v0l/rotator/BOM-aliexpress.md

# Bill of materials, AliExpress version

Searched on AliExpress Ireland on 16 Oct 2026. Prices are in EUR with Irish VAT included,
and each is the listing's lowest option, so the size or quantity you need may cost
more. Delivery is usually free over €10 per seller. Made parts are in `QUOTE.md`.

## Bought on AliExpress

| qty | part | listing | from |
|---|---|---|---|
| 1 | KFL003 flange bearing, 17 mm, pair (az) | [1005007213247542](https://www.aliexpress.com/item/1005007213247542.html) | €7.60 |
| 1 | KFL001 flange bearing, 12 mm option, pair (el) | [1005007098430647](https://www.aliexpress.com/item/1005007098430647.html) | €4.23 |
| 1 | 608-2RS, pack of 10 (4 used) | [1005009361976252](https://www.aliexpress.com/item/1005009361976252.html) | €6.51 |
| 1 | Cable gland M16, IP68, pack of 10 (2 used, az box) | [1005003093251442](https://www.aliexpress.com/item/1005003093251442.html) | €3.62 |
| 1 | Breather vent M12x1.5, IP68 (az box) | [1005012041466313](https://www.aliexpress.com/item/1005012041466313.html) | €3.25 |
| 1 | V-ring VA12, NBR (el lid) | [1005009431336215](https://www.aliexpress.com/item/1005009431336215.html) | €3.46 |
| 1 | Shaft collar 12 mm, set screw (el lid side) | [1005012631701483](https://www.aliexpress.com/item/1005012631701483.html) | €2.96 |
| 2 | Silver steel bar 330 mm, one 8 mm (worm shafts) and one 12 mm (el shaft) | [4000817450571](https://www.aliexpress.com/item/4000817450571.html) | €2.07 each |
| 1 | Feather key 4x4, 304, round ends (el wheel, both arm hubs) | [1005012646738365](https://www.aliexpress.com/item/1005012646738365.html) | €2.80 |
| 1 | Dowel pin Ø4, 304, 30 and 28 long (wheel and collar on the spindle) | [4000473863693](https://www.aliexpress.com/item/4000473863693.html) | €3.05 |
| 1 | Self-clinching nut CLS-M4, 304 (8 used, arm hubs) | [1005012896532691](https://www.aliexpress.com/item/1005012896532691.html) | €3.15 |
| 1 | Hex standoff M3 x 10, aluminium, female-female (4 used, control board) | [1005012423389287](https://www.aliexpress.com/item/1005012423389287.html) | €2.69 |
| 1 | Hex standoff M2.5 x 11, male-female (4 used, optional Pi) | [1005002523300769](https://www.aliexpress.com/item/1005002523300769.html) | €4.43 |
| 2 | Heat-set inserts, brass, 100 pcs, one M3 (gear covers) and one M2.5 (Pi bracket) | [1005006798286851](https://www.aliexpress.com/item/1005006798286851.html) | €4.08 each |
| 1 | Starlock push-on washers, stainless, kit with 4 mm (24 used, parasitic elements) | [1005013043623641](https://www.aliexpress.com/item/1005013043623641.html) | €14.52 |
| 3 | U-bolt, 304, with nuts: M8 for 48 mm (2, mast), M6 for 25 mm (4), M6 for 20 mm (2) | [1005012068399328](https://www.aliexpress.com/item/1005012068399328.html) | €4.64 each |
| 1 | CR123A battery holder with leads | [1005010768477039](https://www.aliexpress.com/item/1005010768477039.html) | €0.52 |
| 5 | Aluminium rod 4 mm, 6061, 1 m (yagi elements, three per bar) | [1005010503222152](https://www.aliexpress.com/item/1005010503222152.html) | €1.63 each |
| 2 | A4 countersunk socket screws DIN 7991: M3x8 (2), M3x12 (24, drive plates) | [1005011829285007](https://www.aliexpress.com/item/1005011829285007.html) | €2.10 each |
| 6 | A4 socket cap screws DIN 912: M3x6, M3x10, M3x14, M4x10, M5x12, M6x16, one pack per size | [1005012860629584](https://www.aliexpress.com/item/1005012860629584.html) | €2.69 each |
| 1 | EPDM sheet 1 mm (gasket under the outside el bearing unit) | [1005011772353226](https://www.aliexpress.com/item/1005011772353226.html) | €3.68 |
| 1 | PETG filament 1 kg, about 150 g used (gear covers, accessory bracket) | [1005008941340930](https://www.aliexpress.com/item/1005008941340930.html) | €12.99 |

AliExpress subtotal from the listed prices: about **€134**.

## Bought elsewhere

| qty | part | where | with VAT |
|---|---|---|---|
| 1 | Hammond 1550WH die-cast box, 222 x 146 x 105, IP66 (az) | [Farnell 1823070](https://ie.farnell.com/search?st=1823070) | €43.16 |
| 1 | Hammond 1550Z117 die-cast box, 160 x 100 x 81, IP66 (el) | [Farnell 2763846](https://ie.farnell.com/search?st=2763846) | €36.08 |
| 1 | KHK CG1-60R1 wheel and SW1-R1 worm, m1, 60:1 (az, £46.28) | [R.A. Rodriguez](https://www.rargears.com/gears/worm-wheels/gray-iron-worm-wheels/cg1-60r1) | €67.20 |
| 1 | KHK BG0.8-60R1 bronze wheel and SW0.8-R1 worm, m0.8, 60:1 (el) | R.A. Rodriguez | not priced |
| 2 | StepperOnline 17HS15-1504-ME1K closed-loop NEMA17 (£14.36 each) | [17HS15-1504-ME1K](https://www.omc-stepperonline.com/nema-17-closed-loop-stepper-motor-45ncm-64oz-in-with-magnetic-encoder-1000ppr-4000cpr-17hs15-1504-me1k) | €41.70 |
| 1 | Molex 73100-0037 N jack bulkhead, crimp, RG-58 (el box floor; $13.10 ex VAT) | [Mouser 538-73100-0037](https://www.mouser.com/ProductDetail/Molex/73100-0037?qs=UWfdUHhsSi4LdzZbo9j%252B7A%3D%3D) | not totalled |
| 1 | Aluminium tube 25 x 2, 1 m (yagi bracket, 390 used) | [Goodwins](https://www.goodwins.ie/products/id-30577.html) | €10.95 |
| 1 | Aluminium tube 20 x 1.5, 1 m (yagi boom, 932 used) | [Aluminium Online](https://www.aluminium-online.co.uk) | not priced |
| 1 | 42CrMo4+QT (4140 pre-hard) bar Ø20 x 120 (az spindle) | steel stockholders | not priced |
| 2 | M8 V-saddle for 48 mm tube, A4 (mast clamp) | aerial suppliers | not priced |
| 2 | Dipole centre insulator box for a 20 mm boom (split driven elements) | DK7ZB, WiMo | not priced |
| | O-ring sealing screws: M3x8 (4), M4x10 (4), M4x16 (4), M4x22 (4), M6x16 (2), M6x25 (2); M4 spacers Ø8 x 7.5, A4 (4); nuts M3 (2), M4 (4), M6 nyloc (4), M8 nyloc (4) with sealing washers; washers 5.3 x 20 (2) | [Accu](https://www.accu.co.uk) | not priced |
| 1 | Control board parts (`board/tools/bom.md`) | Mouser | €81.14 |
| 1 | CR123A lithium cell, RJ45 plug for the PoE cable | any | |
| | Optional Pi and SDR: Raspberry Pi 5, PoE HAT, RTL-SDR Blog V4, short USB-A extension | Raspberry Pi resellers, rtl-sdr.com | |

The KHK worm pairs stay because the drive plates hold each worm at the KHK centre
distance (38 mm az, 31 mm el) and the gear covers are drawn around their sizes. The two
boxes stay with Farnell because the whole model and its drilling are drawn around these
Hammond parts.

## Total

About **€414 with VAT** for the priced rows: €134 on AliExpress and €280 elsewhere. The
el worm pair, the N-type bulkhead, the boom tube, the spindle bar, the saddles, the
insulators and the Accu hardware are not in it. Made parts are the same as in `BOM.md`
and still need quotes.

## Before ordering

- The AliExpress KFL units are generic zinc castings. Check the bolt spacing and centre
  height against `parts/std/kfl002.gcad` as used in the assemblies (KFL003 a=71 e=56,
  KFL001 a=63 e=48), since the boxes are drilled to them.
- Pick the 2RS option on the 608 listing and the 12 mm bore on the KFL001 listing.
- The silver steel bar is not ground to a stated tolerance; check it fits the KFL001
  bore, the el wheel bore and the 608 inner rings before cutting the keyways and D-bore.
- Pick the U-bolt sizes for 48, 25 and 20 mm tube on the U-bolt listing.
- Check the aluminium rod listing offers a 1 m length; the longest element is 346 mm.
