v0l/rotator/BOM.md

# Bill of materials (bought parts)

Prices checked on 9 Oct 2026 (Hammond boxes on 16 Oct), unit prices ex VAT. Made parts (plates, yoke, shafts,
collar) and drilling the boxes are in `QUOTE.md`.

## Farnell Ireland (EUR, free delivery over €75)

| qty | part | order code | unit | total |
|---|---|---|---|---|
| 2 | TE 1478769-2 cable gland M16, IP68, with locknut | [1174602](https://ie.farnell.com/te-connectivity/1478769-2/cable-gland-pa-10mm-m16-black/dp/1174602) | €4.07 | €8.14 |
| 1 | TE 2490541-2 breather vent M12x1.5 | [4753219](https://ie.farnell.com/amp-te-connectivity/2490541-2/ventilation-cable-gland-70l-h/dp/4753219) | €4.40 | €4.40 |
| 1 | Hammond 1550WH die-cast box, 222 x 146 x 105, IP66 (az) | [1823070](https://ie.farnell.com/search?st=1823070) | €35.09 | €35.09 |
| 1 | Hammond 1550Z117 die-cast box, 160 x 100 x 81, IP66 (el) | [2763846](https://ie.farnell.com/search?st=2763846) | €29.33 | €29.33 |
| | | | | **€76.96** |

## Simply Bearings Ireland (EUR)

| qty | part | link | unit | total |
|---|---|---|---|---|
| 2 | KFL003 flange bearing unit, 17 mm (az) | [kfl003](https://www.simplybearings.ie/products/kfl003) | €9.82 | €19.64 |
| 4 | SKF 608-2RSH | [608-2rsh-skf](https://www.simplybearings.ie/products/608-2rsh-skf) | €6.12 | €24.48 |
| 1 | Silver steel 8 mm x 325, cut into two 83 mm worm shafts | [ssm0080-325mm](https://www.simplybearings.ie/products/ssm0080-325mm) | €9.26 | €9.26 |
| | | | | **€53.38** |

## R.A. Rodriguez, KHK distributor (UK, GBP)

| qty | part | link | unit | total |
|---|---|---|---|---|
| 1 | KHK CG1-60R1 worm wheel, m1, 60:1, cast iron (az) | [cg1-60r1](https://www.rargears.com/gears/worm-wheels/gray-iron-worm-wheels/cg1-60r1) | £26.86 | £26.86 |
| 1 | KHK SW1-R1 steel worm, m1 (az) | [SW1-R1](https://www.rargears.com/gears/worm-wheels/steel-worms/SW1-R1) | £19.42 | £19.42 |
| | | | | **£46.28** |

The el pair, KHK BG0.8-60R1 (bronze, m0.8, 60:1) and SW0.8-R1, is not price-checked.

The wheels come with plain bores and the worms with 6 mm; the reboring is in `QUOTE.md`. RAR does not list the bronze BG1-60R1. Its
bronze 60:1 option is AG1-60R1J15 (£158.85, already bored 15 mm with keyway), but that
pairs with the SWG1-R1 ground worm (£80.12), which I have not modelled. Shipping from
the UK adds Irish import VAT and a carrier handling fee.

## StepperOnline (GBP, EU warehouse)

| qty | part | link | unit | total |
|---|---|---|---|---|
| 2 | 17HS15-1504-ME1K closed-loop NEMA17, 45 Ncm, magnetic encoder 1000 PPR built in, 43.5 mm long | [17HS15-1504-ME1K](https://www.omc-stepperonline.com/nema-17-closed-loop-stepper-motor-45ncm-64oz-in-with-magnetic-encoder-1000ppr-4000cpr-17hs15-1504-me1k) | £14.36 | £28.72 |
| | | | | **£28.72** |

## Not price-checked yet

| qty | part | where |
|---|---|---|
| 2 | KFL001 flange bearing unit, 12 mm (el) | [Simply Bearings](https://www.simplybearings.co.uk/products/kfl001) |
| 1 | V-ring VA12 nitrile, for 11.5-13.5 mm shafts (el lid) | Simply Bearings |
| 1 | Shaft collar 12 mm, set screw (el lid side) | Simply Bearings |
| 1 | Silver steel 12 mm x 325 (el shaft) | Simply Bearings |
| 1 | 42CrMo4+QT (4140 pre-hard) bar Ø20 x 120 (az spindle) | steel stockholders |
| 2 | Dowel pin Ø4 m6, 30 and 28 long (wheel and collar on the spindle) | Accu |
| 4 | M4 spacer Ø8 x 7.5, A4 (az drive hangers) | Accu |
| 3 | Feather key 4x4, A4 (el wheel, both arm hubs) | Simply Bearings |
| 8 | Self-clinching nut M4 for 3 mm aluminium, PEM CLS-M4-2 or equal (arm hubs) | PennEngineering distributors |
| 2 | M8 U-bolt and V-saddle for 48 mm tube, A4 (mast clamp) | aerial suppliers, Accu |
| 1 | Aluminium tube 25 x 2, 390 mm (yagi bracket) | Goodwins (below) |
| 1 | EPDM sheet 1 mm, for the gasket under the outside el bearing unit | Amazon, Delta Rubber |
| 4 | Hex standoff M3 x 10, female-female, 5.5 mm, aluminium (control board) | [Accu](https://www.accu.co.uk) |
| 1 | Takachi CR123A-R battery holder with 140 mm leads, plus a JST PHR-2 housing and 2 SPH crimps | Conrad, item 1882324 |
| 1 | CR123A lithium cell | any |
| 1 | Molex 73100-0037 N jack bulkhead, crimp, RG-58 (SDR coax out of the el box floor) | [Mouser 538-73100-0037](https://www.mouser.com/ProductDetail/Molex/73100-0037?qs=UWfdUHhsSi4LdzZbo9j%252B7A%3D%3D), $13.10 |
| | Optional Pi and SDR: Raspberry Pi 5, PoE HAT, RTL-SDR Blog V4, 4x M2.5 x 11 male-female standoffs, 4x M2.5 heat-set inserts, 4x M4x10 (bracket to the drive base plate), short USB-A extension | Raspberry Pi resellers, rtl-sdr.com |
| 1 | RJ45 plug for the PoE cable, crimped inside the box after the cable is through the gland | any |
| 1 | Aluminium tube 20 x 1.5, 1 m (yagi boom) | [Aluminium Online](https://www.aluminium-online.co.uk) |
| 5 | Aluminium rod 4 mm, 1 m (yagi elements, three per bar) | [Aluminium Online](https://www.aluminium-online.co.uk) |
| 24 | Push-on star lock washer, 4 mm shaft, A2 (parasitic elements, both sides of the boom) | [Accu](https://www.accu.co.uk) |
| 2 | Dipole centre insulator box for a 20 mm boom (split driven elements) | DK7ZB, WiMo |
| 4 | M6 U-bolt for 25 mm tube, A4, with nuts (two on the cross clamp, two on the yoke) | [Accu](https://www.accu.co.uk) |
| 2 | M6 U-bolt for 20 mm tube, A4, with nuts | [Accu](https://www.accu.co.uk) |
| 12 | Ruthex M3 heat-set insert, 5.7 long (gear covers) | [3DJake Ireland](https://www.3djake.ie/) |
| 1 | PETG filament, about 150 g (gear covers) | [3DJake Ireland](https://www.3djake.ie/) |
| | A4 screws: M3x6 (4), M3x8 countersunk (2), M3x10 (16), M3x12 countersunk (24, drive plates), M3x14 (4), M4x10 (8, arm hubs), M5x12 (2, el shaft ends), M6x16 (4); O-ring sealing screws: M3x8 (4, board), M4x10 (4, el drive base plate), M4x16 (4, az drive hangers), M4x22 (4, collar), M6x16 (2, el KFLs through the walls), M6x25 (2, az KFL003 pair); nuts M3 (2), M4 (4), M6 (4, nyloc), M8 nyloc (4) with sealing washers (mast U-bolts inside the az box); washers 5.3 x 20 (2) | [Accu](https://www.accu.co.uk) |

## Totals in EUR with 23% VAT

GBP converted at 1.1805 (mid-market, 9 Oct 2026). Shipping not included.

| supplier | ex VAT | with VAT |
|---|---|---|
| Farnell Ireland | €76.96 | €94.66 |
| Simply Bearings Ireland | €53.38 | €65.66 |
| R.A. Rodriguez (£46.28) | €54.63 | €67.20 |
| StepperOnline (£28.72) | €33.90 | €41.70 |
| Goodwins, 25 mm tube x 1 m | €8.90 | €10.95 |
| Control board parts, Mouser (`board/tools/bom.md`) | €65.97 | €81.14 |
| **priced parts** | **€293.74** | **€361.31** |

The unpriced rows include the el worm pair and the KFL001s, so the
priced total is well short of the bought parts; they need pricing before the total means
anything. The control board PCB (4 layers, ENIG, JLCPCB) and its assembly are not priced yet,
and its STM32H563RIT6 is on backorder (Mouser expects stock on 11 Dec 2026). The made parts in
`QUOTE.md` still need quotes.

## Other Irish suppliers

Found by search, stock and prices not checked unless noted.

| need | supplier |
|---|---|
| Bearings, KFL units, taper-lock bushes and hubs, couplings | [Central Bearing Supplies](https://www.cbsbearings.com/), [Dickson Bearings](https://dicksonbearings.ie/), [Bearings Online](https://www.bearingsonline.ie/), [MecTec](http://www.mectec.ie/store/bearings) |
| Worm wheels | [RS Ireland](https://ie.rs-online.com/web/c/mechanical-power-transmission/gears-racks/worm-pinion-gears/) (RS PRO bronze wheels), [C.H.L. Engineering](http://www.chlengineering.ie/product-types/gears) (cut to order) |
| A4 stainless screws, nuts, washers | [Inox.ie](https://www.inox.ie/acatalog/Cap_Screws.html), [Bolts and Nuts](https://www.boltsandnuts.ie/), [Würth Ireland](https://eshop.wurth.ie/) (trade accounts) |
| NEMA17 motors, maker parts | [Gleanntronics](https://gleanntronics.ie/), [3DJake Ireland](https://www.3djake.ie/), [Mouser Ireland](https://www.mouser.ie/) |
| 25 mm aluminium tube | [Goodwins](https://www.goodwins.ie/products/id-30577.html) (25 mm x 1 m, €8.90 ex VAT, 15 in stock), [Lenehans](https://www.lenehans.ie/round-profile-anodised-aluminium-25mm-x-1m.html), [Impact Aluminium](https://www.impactaluminium.ie/product-category/profile/tube/) |
| Cable glands | [Electrical Wholesaler Ireland](https://www.electricalwholesaler.ie/en/products/m16-cable-gland-locknut-grey-5-10mm-cable-entry-ip68-q-crimp) (M16 IP68, pack of 10) |
| Laser-cut plates | [ATC Group](https://atcgroup.ie/laser-cutting-quote/), [Laserprofiling.ie](https://laserprofiling.ie/), [lasercutting.ie](http://www.lasercutting.ie/), [CS Fabrication](https://www.csfabrication.ie/laser-cutting/) |
| Turned and milled parts | [ProNum CNC](https://pronum.ie/), [Profab Services](https://www.profabservices.ie/services/precision-engineering), [cnc.ie quote form](https://www.cnc.ie/get-a-quote.html) (routes to several Irish shops) |
