v0l/rotator/board/tools/bom.md

| Refs | Qty | Value | MPN | Maker | Source | Stock | EUR each (1 board) | EUR each (5 boards) |
|---|---|---|---|---|---|---|---|---|
| C1 | 1 | 10n/100V | GRM21BR72A103KA01L | Murata | Mouser 81-GRM21BR72A103K | 76699 | 0.163 | 0.163 |
| C2 | 1 | 330u/35V | EEH-ZK1V331P | Panasonic | Mouser 667-EEH-ZK1V331P | 10876 | 1.430 | 1.430 |
| C3 | 1 | 10u/50V | C3216X5R1H106K160AB | TDK | Mouser 810-C3216X5R1H106K | 85290 | 1.590 | 1.590 |
| C4 | 1 | 100n/50V | GRM155R71H104KE14D | Murata | Mouser 81-GRM155R71H104KE4D | 16438135 | 0.086 | 0.086 |
| C5 C6 C93 | 3 | 22u/10V | CL21A226MPCLRNC | Samsung | Mouser 187-CL21A226MPCLRNC | 10385 | 0.387 | 0.222 |
| C7 | 1 | 100p/50V | GRM1555C1H101JA01D | Murata | Mouser 81-GRM1555C1H101JA1D | 262856 | 0.095 | 0.095 |
| C20 C23 C24 C25 C26 C28 C30 C63 C64 C66 C75 C82 C98 | 13 | 100n/10V | GRM155R71A104KA01D | Murata | Mouser 81-GRM155R71A104KA1D | 12004 | 0.022 | 0.015 |
| C21 C22 | 2 | 6.8p/50V | GRM1555C1H6R8CA01D | Murata | Mouser 81-GRM1555C1H6R8CA1D | 151365 | 0.103 | 0.024 |
| C27 | 1 | 4.7u/10V | C1005X5R1A475K050BC | TDK | Mouser 810-C1005X5R1A475KBC | 1184417 | 0.241 | 0.241 |
| C29 C62 C65 C67 C89 C92 C99 | 7 | 1u/10V | GRM155R61E105MA12D | Murata | Mouser 81-GRM155R61E105MA2D | 319113 | 0.086 | 0.031 |
| C31 C32 | 2 | 2.2u/10V | GRM155R61A225ME01D | Murata | Mouser 81-GRM155R61A225M01D | 2140 | 0.086 | 0.022 |
| C59 C69 C72 C79 | 4 | 22n/50V | GRM155R71H223KA12D | Murata | Mouser 81-GRM155R71H223KA12 | 148519 | 0.095 | 0.021 |
| C60 C61 | 2 | 15p/50V | GRM1555C1H150JA01D | Murata | Mouser 81-GRM1555C1H150JA1D | 156394 | 0.086 | 0.020 |
| C68 | 1 | 470p/50V | GRM1555C1H471JA01D | Murata | Mouser 81-GRM1555C1H471JA01 | 434754 | 0.086 | 0.086 |
| C70 C71 C73 C77 C78 C80 | 6 | 100n/50V | GCM188R71H104KA57D | Murata | Mouser 81-GCM188R71H104KA7D | 400000 | 0.032 | 0.032 |
| C74 C81 | 2 | 4.7u/10V | C0603C475K8PAC | KEMET | Mouser 80-C0603C475K8PAC | 84000 | 0.047 | 0.047 |
| C76 C83 | 2 | 100u/35V | EHBSA035M1010608T | Eaton | Mouser 504-EHBSA035M1010608 | 4633 | 0.955 | 0.608 |
| C90 C91 | 2 | 10u/10V | GRM188R61A106ME69D | Murata | Mouser 81-GRM188R61A106ME9D | 14985 | 0.103 | 0.058 |
| D1 D2 | 2 | MDB10S | MDB10S | onsemi | Mouser 512-MDB10S | 30184 | 0.654 | 0.297 |
| D4 D5 D10 | 3 | B5819W | 1N5819HW-7-F | Diodes | Mouser 621-1N5819HW-F | 424904 | 0.267 | 0.117 |
| FB1 | 1 | 600R | BLM18KG601SN1D | Murata | Mouser 81-BLM18KG601SN1D | 1118109 | 0.086 | 0.086 |
| J1 | 1 | V8BR-1AX1-GH | V8BR-1AX1-GH | Bel | Farnell 3588276 |  | 9.310 | 9.310 |
| J4 J5 | 2 | AZ_ENCODER | B5B-XH-A(LF)(SN) | JST | Mouser 306-B5BXHALFSN | 41491 | 0.172 | 0.149 |
| J7 | 1 | USB4960 | USB4960-00-C | GCT | Mouser 640-USB4960-00-C | 8823 | 0.619 | 0.619 |
| J8 J9 | 2 | AZ_MOTOR | B4B-XH-A(LF)(SN) | JST | Mouser 306-B4BXHALFSN | 63101 | 0.146 | 0.124 |
| J10 | 1 | BATTERY | B2B-PH-K-S(LF)(SN) | JST | Mouser 306-B2BPHKSLFSNPP | 13876 | 0.103 | 0.103 |
| L1 | 1 | 6.8u | SRN4018-6R8M | Bourns | Mouser 652-SRN4018-6R8M | 2701 | 0.344 | 0.344 |
| L3 | 1 | 2.2u | DFE201610E-2R2M=P2 | Murata | Mouser 81-DFE201610E-2R2MP2 | 39805 | 0.215 | 0.215 |
| LED1 | 1 | green | LTST-C191KGKT |  | Mouser 859-LTST-C191KGKT | 1781213 | 0.129 | 0.129 |
| LED2 | 1 | red | LTST-C191KRKT |  | Mouser 859-LTST-C191KRKT | 1323353 | 0.129 | 0.129 |
| R1 | 1 | 24k | ERJ-8ENF2402V | Panasonic | Mouser 667-ERJ-8ENF2402V | 18348 | 0.155 | 0.155 |
| R2 | 1 | 47k | RC0402FR-0747KL | Yageo | Mouser 603-RC0402FR-0747KL | 2308419 | 0.086 | 0.086 |
| R3 | 1 | 205k | RC0402FR-07205KL | Yageo | Mouser 603-RC0402FR-07205KL | 1034710 | 0.086 | 0.086 |
| R4 | 1 | 62k | RC0402FR-0762KL | Yageo | Mouser 603-RC0402FR-0762KL | 271380 | 0.086 | 0.086 |
| R5 | 1 | 499 | RC0402FR-07499RL | Yageo | Mouser 603-RC0402FR-07499RL | 635026 | 0.086 | 0.086 |
| R22 R29 R36 R42 | 4 | 10k | RC0402FR-0710KL | Yageo | Mouser 603-RC0402FR-0710KL | 16045441 | 0.086 | 0.009 |
| R23 R24 | 2 | 5.1k | RC0402FR-075K1L | Yageo | Mouser 603-RC0402FR-075K1L | 1987011 | 0.086 | 0.009 |
| R27 R46 | 2 | 1k | RC0402FR-071KL | Yageo | Mouser 603-RC0402FR-071KL | 3519849 | 0.086 | 0.009 |
| R28 | 1 | 2.2k | RC0402FR-072K2L | Yageo | Mouser 603-RC0402FR-072K2L | 1787135 | 0.095 | 0.095 |
| R30 | 1 | 12.1k | RC0402FR-0712K1L | Yageo | Mouser 603-RC0402FR-0712K1L | 449359 | 0.086 | 0.086 |
| R31 R32 R33 R34 | 4 | 49.9 | RC0402FR-0749R9L | Yageo | Mouser 603-RC0402FR-0749R9L | 2119239 | 0.086 | 0.009 |
| R35 | 1 | 33 | RC0402FR-0733RL | Yageo | Mouser 603-RC0402FR-0733RL | 1235798 | 0.086 | 0.086 |
| R37 | 1 | 1.5k | RC0402FR-071K5L | Yageo | Mouser 603-RC0402FR-071K5L | 1167927 | 0.086 | 0.086 |
| R40 R41 R43 R44 | 4 | 0.11 | RL1632R-R110-F | Susumu | Mouser 754-RL1632R-R110-F | 16159 | 0.232 | 0.193 |
| R50 R57 | 2 | 1M | RC0402FR-071ML | Yageo | Mouser 603-RC0402FR-071ML | 1730803 | 0.086 | 0.009 |
| R52 | 1 | 180k | RC0402FR-07180KL | Yageo | Mouser 603-RC0402FR-07180KL | 251440 | 0.086 | 0.086 |
| R53 R54 | 2 | 100k | RC0402FR-07100KL | Yageo | Mouser 603-RC0402FR-07100KL | 5631536 | 0.086 | 0.009 |
| R58 | 1 | 487k | RC0402FR-07487KL | Yageo | Mouser 603-RC0402FR-07487KL | 605870 | 0.086 | 0.086 |
| R59 | 1 | 200k | RC0402FR-07200KL | Yageo | Mouser 603-RC0402FR-07200KL | 1029898 | 0.086 | 0.086 |
| R63 R64 R65 R66 R67 R68 | 6 | 220 | RC0402FR-07220RL | Yageo | Mouser 603-RC0402FR-07220RL | 498023 | 0.086 | 0.009 |
| SW1 SW2 | 2 | RESET | PTS810SJM250SMTRLFS | C&K | Mouser 611-PTS810SJM250SMTR | 50906 | 0.482 | 0.431 |
| U1 | 1 | Ag5424 | Ag5424 | Silvertel | Mouser 480-AG5424 | 1059 | 13.670 | 13.670 |
| U2 | 1 | LTV-357T | LTV-357T | Liteon | Mouser 859-LTV-357T | 34712 | 0.370 | 0.370 |
| U3 | 1 | AP63201WU | AP63201WU-7 | Diodes | Mouser 621-AP63201WU-7 | 10539 | 0.817 | 0.817 |
| U5 | 1 | TPS61099DRV | TPS61099DRVR | TI | Mouser 595-TPS61099DRVR | 174 | 1.480 | 1.480 |
| U6 | 1 | TPS2116DRL | TPS2116DRLR | TI | Mouser 595-TPS2116DRLR | 80465 | 0.903 | 0.903 |
| U10 | 1 | STM32H563RIT6 | STM32H563RIT6 | ST | Mouser 511-STM32H563RIT6 | 0 | 7.710 | 7.710 |
| U12 U13 | 2 | TMC2209-LA | TMC2209-LA-T | ADI | Mouser 700-TMC2209-LA-T | 10955 | 4.970 | 3.780 |
| U14 | 1 | LAN8720A | LAN8720AI-CP-TR | Microchip | Mouser 886-LAN8720AI-CP-TR | 35291 | 1.090 | 1.090 |
| U15 | 1 | USBLC6-2SC6 | USBLC6-2SC6 | ST | Mouser 511-USBLC6-2SC6 | 239731 | 0.507 | 0.507 |
| U16 U17 | 2 | USBLC6-4SC6 | USBLC6-4SC6 | ST | Mouser 511-USBLC6-4SC6 | 47510 | 0.507 | 0.264 |
| Y1 | 1 | 32.768k | FC-135 32.7680KA-AG0 | Epson | Mouser 732-FC135-32.76KAAG0 | 24401 | 0.421 | 0.421 |
| Y2 | 1 | 25MHz | ECS-250-12-33B-CWY-TR3 | ECS | Mouser 520-EC2501233BCWYTR3 | 4203 | 0.361 | 0.361 |

Parts for 1 board: EUR 65.93. Parts for 5 boards: EUR 286.94 (EUR 57.39 a board).
