v0l/rotator/board/models/usbc_hro.step

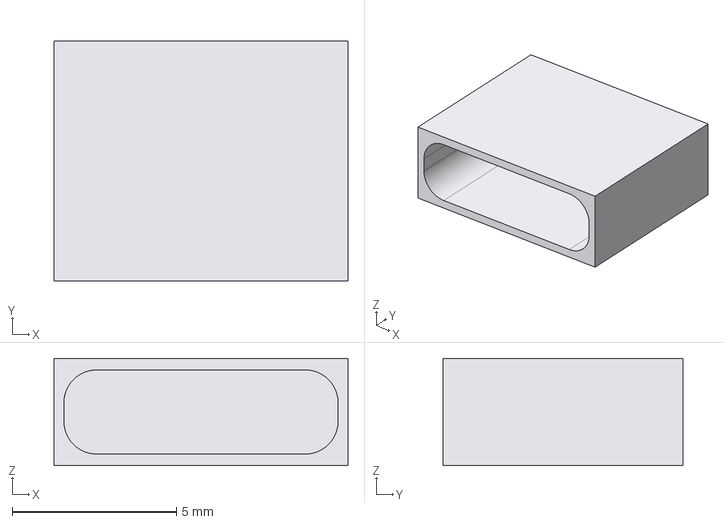
[picture p5: CAD file, 2026-10-09]
board/models/usbc_hro.step
8.94 x 7.30 x 3.26 mm
