v0l/rotator/(commit log)

2026-10-08 Az/el rotator in gcad
2026-10-08 Move mast clamp O-ring inside floor holes
2026-10-09 Die-cast boxes and flange bearing units
2026-10-09 BOM with prices, cross-bolted crossboom, CG1-60R1 wheels
2026-10-09 Shaft rows match BOM stock
2026-10-09 Irish suppliers in BOM
2026-10-09 BOM totals in EUR with VAT
2026-10-09 AliExpress BOM
2026-10-09 Closed-loop steppers with built-in encoders
2026-10-09 PoE control board
2026-10-09 Fit the control board in the az box
2026-10-10 Drop turret and chassis plates
2026-10-10 Fourth bearing plate post
2026-10-10 Bearing loads from KFL002 data
2026-10-11 Board review fixes, vertical USB-C
2026-10-12 Keep switch silk off the pads
2026-10-12 Label switches RESET and BOOT
2026-10-12 USB4960 stake slots and peg hole per drawing
2026-10-12 USB4960 slot note
2026-10-12 Mouser cut tape caps, order sheet
2026-10-12 Printed grease covers on both worm drives
2026-10-12 Crossed 7-element 70 cm yagi
2026-10-12 Helical worm and wheel, gravity torque sim
2026-10-12 Worm hub inside the thread root
2026-10-12 Worm losses and wind torque in the torque sim
2026-10-12 Bearing and seal drag on every joint
2026-10-13 Worm mesh geometry, motor at 0.36 N·m
2026-10-13 Az drive assembly sim
2026-10-13 Az drive sim on KFL bearings and the top plate
2026-10-13 Split into az stage, head and drive sub-assemblies
2026-10-13 Direct-coupled compact worm drive
2026-10-14 Bolt the el bearings straight to the box, drop the el V-rings
2026-10-14 Cut-plate worm drive
2026-10-14 Az box on end, side-mounted on the mast (head not yet back)
2026-10-14 U-yoke el head on a 1550Z117 with an m0.8 worm
2026-10-14 Narrower el head: lid KFL inside, arms keyed on the shaft
2026-10-14 Accessory mounts on the drive top plate, docs for the new layout
2026-10-14 Printed Pi and SDR bracket on the az drive
2026-10-14 Cable-tie slots for the SDR instead of a cage
2026-10-14 Taller, full-width Pi bracket with side plates, moved left
2026-10-14 Keep the SDR tie slots off the side plate
2026-10-14 Pi bracket: ribs back, moved toward +x
2026-10-14 Longer Pi bracket ribs
2026-10-14 Pi Zero and M3 grid holes on the accessory bracket
2026-10-14 Hollow az spindle carries the cables across the az joint
2026-10-14 Round cable hole in the az spindle, E355+SR, spindle FEA
2026-10-14 Two Ø5 cable holes in the az spindle
2026-10-14 Short hollow az spindle on a KFL003 pair, drive up top
2026-10-14 Tie the coax gland to the el box
2026-10-14 El range -6..120, el worm turns the right way
2026-10-14 3 mm laser-cut yoke, bent, with pressed darts
2026-10-14 Gear cover flat on both faces
2026-10-14 Printed cable guide from the el top gland to the spindle
2026-10-14 Smooth el cable guide, flanged to the collar
2026-10-14 Print the el cable guide on its flange
2026-10-15 Near-straight oversize el cable guide, fused to flange
2026-10-15 Cable guide: plain open top, no offset ferrule
2026-10-15 Align the el cable guide with the gland
2026-10-16 N-type bulkhead low on the el box floor
2026-10-16 AliExpress BOM for the current layout
